aaditya-dharamshi/devboard_v1/README.md

# devboard_v1
STM32 devboard, originally developed for FIA SeeGoals
