aaditya-dharamshi/devboard_v1/Docs and Images/devboard_v1_schematic.pdf

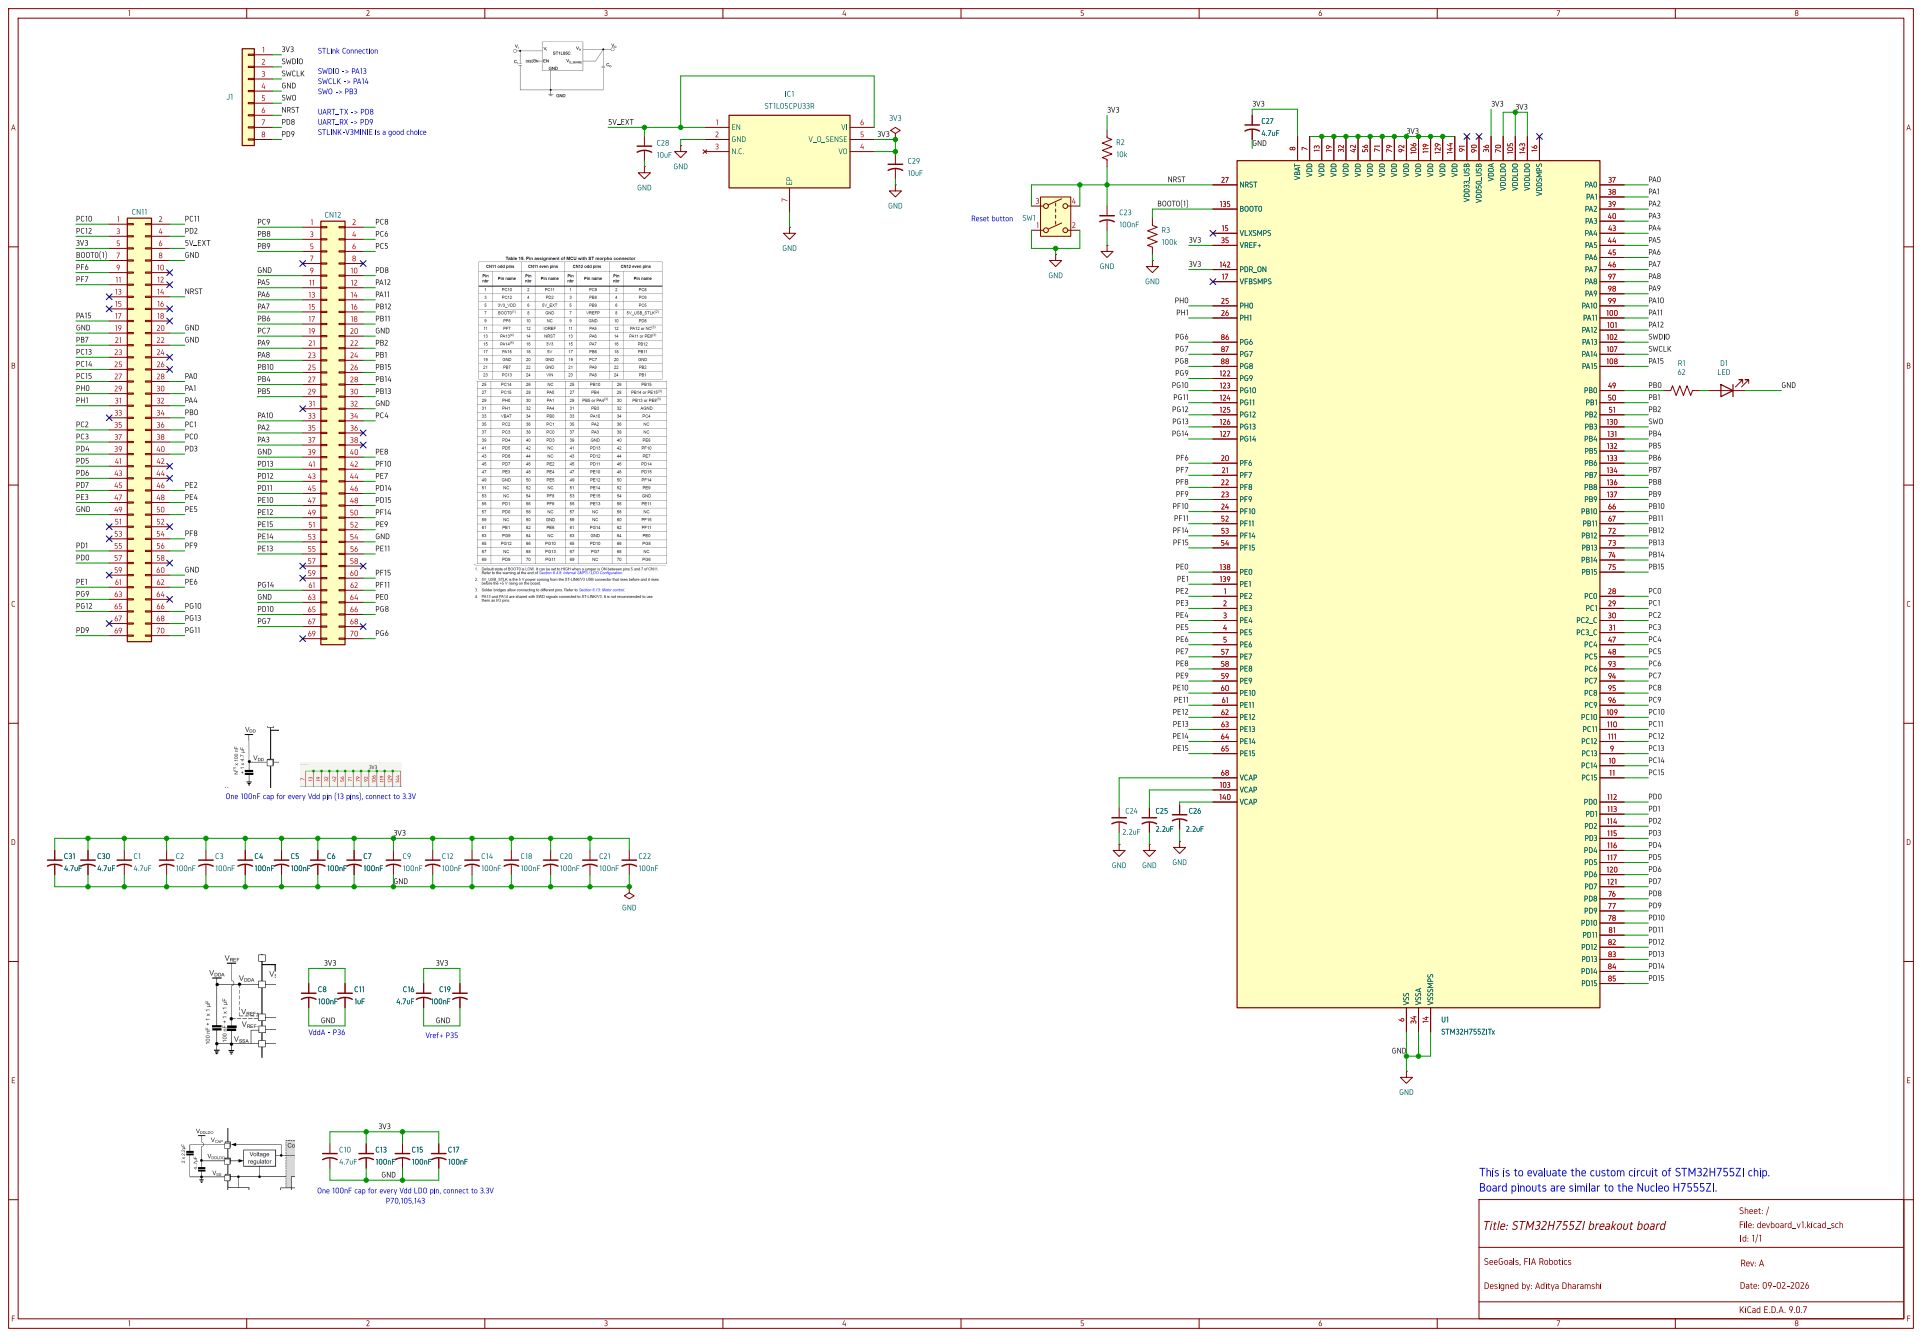
[picture p1: page 1]

6 VDD 106 VSSA 34 VDD 119 VSSSMPS 14 VDD 129 VDD 144 VDD33_USB91 VDD50_USB90 VDDA 36 VDDLDO 70 VDDLDO 105 VDDLDO 143 VDDSMPS 16 PA0 37 PA1 38 PA2 39 PA3 40 PA4 43 PA5 44 PA6 45 PA7 46 PA8 97 PA9 98 PA10 99 PA11 100 PA12 101 PA13 102 PA14 107 PA15 108 PB0 49 PB1 50 PB2 51 PB3 130 PB4 131 PB5 132 PB6 133 PB7 134 PB8 136 PB9 137 PB10 66 PB11 67 PB12 72 PB13 73 PB14 74 PB15 75 PC0 28 PC1 29 PC2_C 30 PC3_C 31 PC4 47 PC5 48 PC6 93 PC7 94 PC8 95 PC9 96 PC10 109 PC11 110 PC12 111 PC13 9 PC14 10 PC15 11 PD0 112 PD1 113 PD2 114 PD3 115 PD4 116 PD5 117 PD6 120 PD7 121 PD8 76 PD9 77 PD10 78 PD11 81 PD12 82 PD13 83 PD14 84 PD15 85 C5

6 VDD 106 VSSA 34 VDD 119 VSSSMPS 14 VDD 129 VDD 144 VDD33_USB91 VDD50_USB90 VDDA 36 VDDLDO 70 VDDLDO 105 VDDLDO 143 VDDSMPS 16 PA0 37 PA1 38 PA2 39 PA3 40 PA4 43 PA5 44 PA6 45 PA7 46 PA8 97 PA9 98 PA10 99 PA11 100 PA12 101 PA13 102 PA14 107 PA15 108 PB0 49 PB1 50 PB2 51 PB3 130 PB4 131 PB5 132 PB6 133 PB7 134 PB8 136 PB9 137 PB10 66 PB11 67 PB12 72 PB13 73 PB14 74 PB15 75 PC0 28 PC1 29 PC2_C 30 PC3_C 31 PC4 47 PC5 48 PC6 93 PC7 94 PC8 95 PC9 96 PC10 109 PC11 110 PC12 111 PC13 9 PC14 10 PC15 11 PD0 112 PD1 113 PD2 114 PD3 115 PD4 116 PD5 117 PD6 120 PD7 121 PD8 76 PD9 77 PD10 78 PD11 81 PD12 82 PD13 83 PD14 84 PD15 85 U1STM32H755ZITx

7 VDD 13 VDD 19 VDD 32 VDD 42 VDD 56 VDD 71 VDD 79 VDD 92 VSS
