aaditya-dharamshi/devboard_v1/devboard_v1.kicad_pcb

## KiCad design devboard_v1.kicad_pcb (2026-03-02)

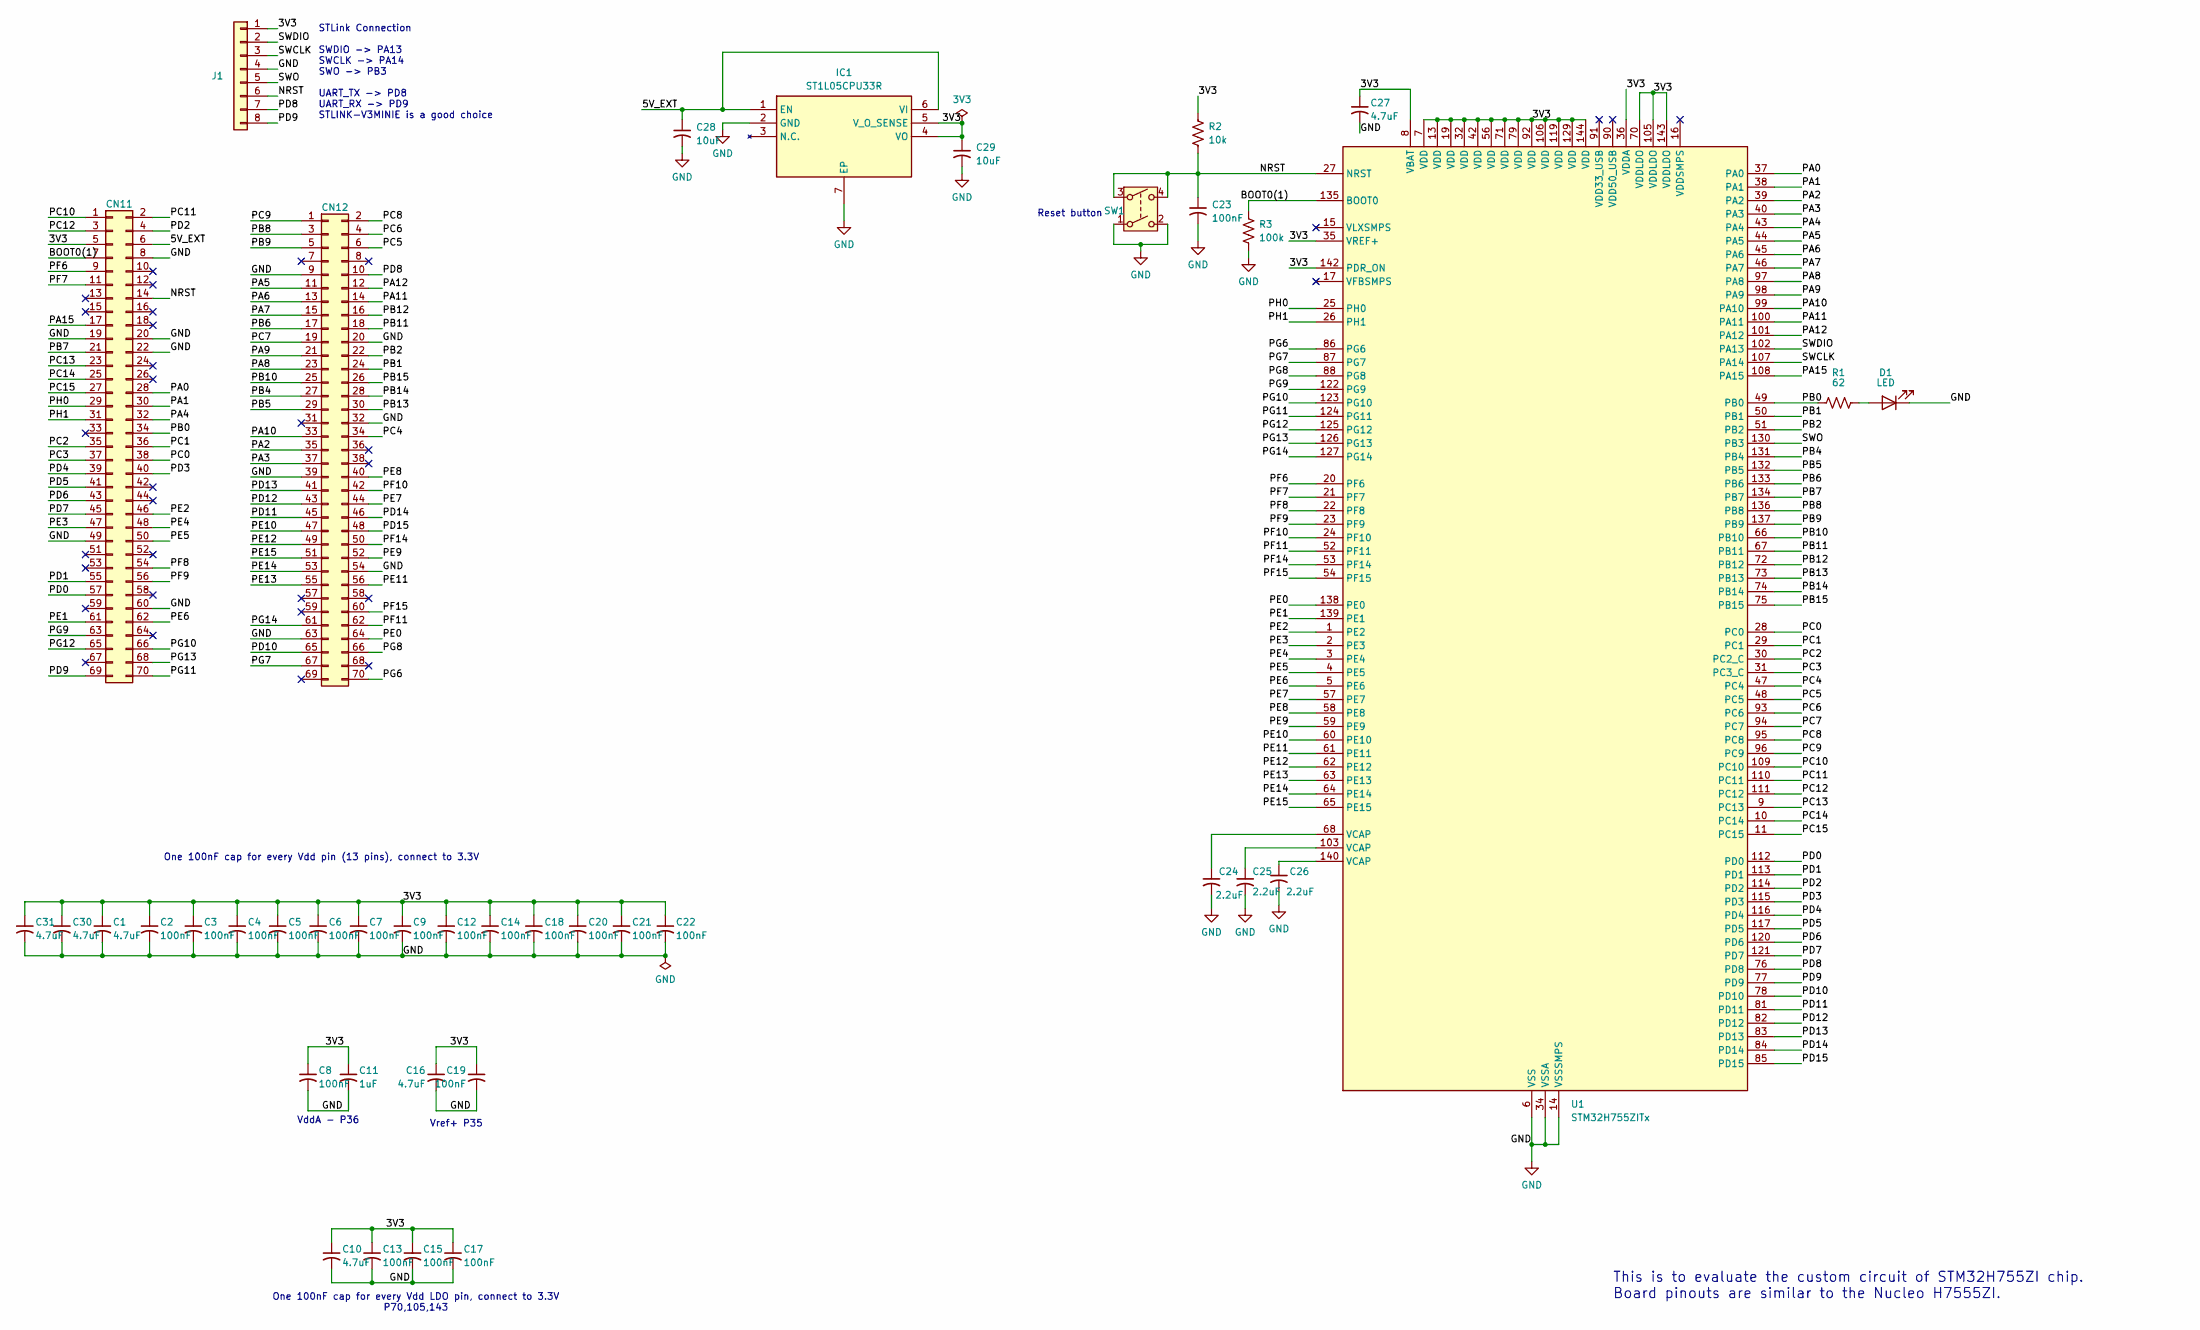
[picture p6: schematic devboard_v1.kicad_sch, STM32H755ZI breakout board]

Parts:
C1, C10, C16, C27, C30, C31: 4.7uF; C_0402_1005Metric; JLCPCB C23733
C2, C3, C4, C5, C6, C7, C8, C9, C12, C13, C14, C15, C17, C18, C19, C20, C21, C22, C23: 100nF; C_0402_1005Metric; JLCPCB C1525
C11: 1uF; C_0402_1005Metric; JLCPCB C14445
C24, C25, C26: 2.2uF; C_0402_1005Metric; JLCPCB C107369
C28, C29: 10uF; C_0402_1005Metric; JLCPCB C315248
CN11, CN12: Conn_02x36_Counter_Clockwise; PinHeader_2x35_P2.54mm_Vertical
D1: LED; LED_0603_1608Metric; JLCPCB C2286
IC1: ST1L05CPU33R; SON95P300X300X100-7N-D; Manufacturer_Part_Number ST1L05CPU33R; Mouser Part Number 511-ST1L05CPU33R
J1: Conn_01x08; PinSocket_1x08_P2.54mm_Vertical
R1: 62; R_0402_1005Metric; JLCPCB C412968
R2: 10k; R_0402_1005Metric; JLCPCB C71617
R3: 100k; R_0402_1005Metric; JLCPCB C191569
SW1: CK_KMS2xxG; TPS645-5NC105_JLCPCB; JLCPCB C19191549
U1: STM32H755ZITx; LQFP-144_20x20mm_P0.5mm; JLCPCB C730212

Connections:
/3V3: C1.1, C2.1, C3.1, C4.1, C5.1, C6.1, C7.1, C8.1, C9.1, C10.1, C11.1, C12.1, C13.1, C14.1, C15.1, C16.1, C17.1, C18.1, C19.1, C20.1, C21.1, C22.1, C27.1, C29.1, C30.1, C31.1, CN11.5, IC1.4 (VO), IC1.5 (V_O_SENSE), J1.1, R2.1, U1.7 (VDD), U1.8 (VBAT), U1.13 (VDD), U1.19 (VDD), U1.32 (VDD), U1.35 (VREF+), U1.36 (VDDA), U1.42 (VDD), U1.56 (VDD), U1.70 (VDDLDO), U1.71 (VDD), U1.79 (VDD), U1.92 (VDD), U1.105 (VDDLDO), U1.106 (VDD), U1.119 (VDD), U1.129 (VDD), U1.142 (PDR_ON), U1.143 (VDDLDO), U1.144 (VDD)
/5V_EXT: C28.1, CN11.6, IC1.1 (EN), IC1.6 (VI)
/BOOT0(1): CN11.7, R3.1, U1.135 (BOOT0)
/NRST: C23.1, CN11.14, J1.6, R2.2, SW1.3, SW1.4, U1.27 (NRST)
/PA0: CN11.28, U1.37 (PA0)
/PA1: CN11.30, U1.38 (PA1)
/PA2: CN12.35, U1.39 (PA2)
/PA3: CN12.37, U1.40 (PA3)
/PA4: CN11.32, U1.43 (PA4)
/PA5: CN12.11, U1.44 (PA5)
/PA6: CN12.13, U1.45 (PA6)
/PA7: CN12.15, U1.46 (PA7)
/PA8: CN12.23, U1.97 (PA8)
/PA9: CN12.21, U1.98 (PA9)
/PA10: CN12.33, U1.99 (PA10)
/PA11: CN12.14, U1.100 (PA11)
/PA12: CN12.12, U1.101 (PA12)
/PA15: CN11.17, U1.108 (PA15)
/PB0: CN11.34, R1.1, U1.49 (PB0)
/PB1: CN12.24, U1.50 (PB1)
/PB2: CN12.22, U1.51 (PB2)
/PB4: CN12.27, U1.131 (PB4)
/PB5: CN12.29, U1.132 (PB5)
/PB6: CN12.17, U1.133 (PB6)
/PB7: CN11.21, U1.134 (PB7)
/PB8: CN12.3, U1.136 (PB8)
/PB9: CN12.5, U1.137 (PB9)
/PB10: CN12.25, U1.66 (PB10)
/PB11: CN12.18, U1.67 (PB11)
/PB12: CN12.16, U1.72 (PB12)
/PB13: CN12.30, U1.73 (PB13)
/PB14: CN12.28, U1.74 (PB14)
/PB15: CN12.26, U1.75 (PB15)
/PC0: CN11.38, U1.28 (PC0)
/PC1: CN11.36, U1.29 (PC1)
/PC2: CN11.35, U1.30 (PC2_C)
/PC3: CN11.37, U1.31 (PC3_C)
/PC4: CN12.34, U1.47 (PC4)
/PC5: CN12.6, U1.48 (PC5)
/PC6: CN12.4, U1.93 (PC6)
/PC7: CN12.19, U1.94 (PC7)
/PC8: CN12.2, U1.95 (PC8)
/PC9: CN12.1, U1.96 (PC9)
/PC10: CN11.1, U1.109 (PC10)
/PC11: CN11.2, U1.110 (PC11)
/PC12: CN11.3, U1.111 (PC12)
/PC13: CN11.23, U1.9 (PC13)
/PC14: CN11.25, U1.10 (PC14)
/PC15: CN11.27, U1.11 (PC15)
/PD0: CN11.57, U1.112 (PD0)
/PD1: CN11.55, U1.113 (PD1)
/PD2: CN11.4, U1.114 (PD2)
/PD3: CN11.40, U1.115 (PD3)
/PD4: CN11.39, U1.116 (PD4)
/PD5: CN11.41, U1.117 (PD5)
/PD6: CN11.43, U1.120 (PD6)
/PD7: CN11.45, U1.121 (PD7)
/PD8: CN12.10, J1.7, U1.76 (PD8)
/PD9: CN11.69, J1.8, U1.77 (PD9)
/PD10: CN12.65, U1.78 (PD10)
/PD11: CN12.45, U1.81 (PD11)
/PD12: CN12.43, U1.82 (PD12)
/PD13: CN12.41, U1.83 (PD13)
/PD14: CN12.46, U1.84 (PD14)
/PD15: CN12.48, U1.85 (PD15)
/PE0: CN12.64, U1.138 (PE0)
/PE1: CN11.61, U1.139 (PE1)
/PE2: CN11.46, U1.1 (PE2)
/PE3: CN11.47, U1.2 (PE3)
/PE4: CN11.48, U1.3 (PE4)
/PE5: CN11.50, U1.4 (PE5)
/PE6: CN11.62, U1.5 (PE6)
/PE7: CN12.44, U1.57 (PE7)
/PE8: CN12.40, U1.58 (PE8)
/PE9: CN12.52, U1.59 (PE9)
/PE10: CN12.47, U1.60 (PE10)
/PE11: CN12.56, U1.61 (PE11)
/PE12: CN12.49, U1.62 (PE12)
/PE13: CN12.55, U1.63 (PE13)
/PE14: CN12.53, U1.64 (PE14)
/PE15: CN12.51, U1.65 (PE15)
/PF6: CN11.9, U1.20 (PF6)
/PF7: CN11.11, U1.21 (PF7)
/PF8: CN11.54, U1.22 (PF8)
/PF9: CN11.56, U1.23 (PF9)
/PF10: CN12.42, U1.24 (PF10)
/PF11: CN12.62, U1.52 (PF11)
/PF14: CN12.50, U1.53 (PF14)
/PF15: CN12.60, U1.54 (PF15)
/PG6: CN12.70, U1.86 (PG6)
/PG7: CN12.67, U1.87 (PG7)
/PG8: CN12.66, U1.88 (PG8)
/PG9: CN11.63, U1.122 (PG9)
/PG10: CN11.66, U1.123 (PG10)
/PG11: CN11.70, U1.124 (PG11)
/PG12: CN11.65, U1.125 (PG12)
/PG13: CN11.68, U1.126 (PG13)
/PG14: CN12.61, U1.127 (PG14)
/PH0: CN11.29, U1.25 (PH0)
/PH1: CN11.31, U1.26 (PH1)
/SWCLK: J1.3, U1.107 (PA14)
/SWDIO: J1.2, U1.102 (PA13)
/SWO: J1.5, U1.130 (PB3)
GND: C1.2, C2.2, C3.2, C4.2, C5.2, C6.2, C7.2, C8.2, C9.2, C10.2, C11.2, C12.2, C13.2, C14.2, C15.2, C16.2, C17.2, C18.2, C19.2, C20.2, C21.2, C22.2, C23.2, C24.2, C25.2, C26.2, C27.2, C28.2, C29.2, C30.2, C31.2, CN11.8, CN11.19, CN11.20, CN11.22, CN11.49, CN11.60, CN12.9, CN12.20, CN12.32, CN12.39, CN12.54, CN12.63, D1.1 (K), IC1.2 (GND), IC1.7 (EP), J1.4, R3.2, SW1.1, SW1.2, U1.6 (VSS), U1.12 (VSS), U1.14 (VSSSMPS), U1.18 (VSS), U1.33 (VSS), U1.34 (VSSA), U1.41 (VSS), U1.55 (VSS), U1.69 (VSS), U1.80 (VSS), U1.89 (VSS), U1.104 (VSS), U1.118 (VSS), U1.128 (VSS), U1.141 (VSS)
unnamed: C24.1, U1.68 (VCAP)
unnamed: C25.1, U1.103 (VCAP)
unnamed: C26.1, U1.140 (VCAP)
unnamed: D1.2 (A), R1.2

Notes on the sheet:
VddA - P36
STLink Connection SWDIO -> PA13 SWCLK -> PA14 SWO -> PB3 UART_TX -> PD8 UART_RX -> PD9 STLINK-V3MINIE is a good choice
Vref+ P35
Reset button
One 100nF cap for every Vdd LDO pin, connect to 3.3V P70,105,143
This is to evaluate the custom circuit of STM32H755ZI chip. Board pinouts are similar to the Nucleo H7555ZI.
One 100nF cap for every Vdd pin (13 pins), connect to 3.3V

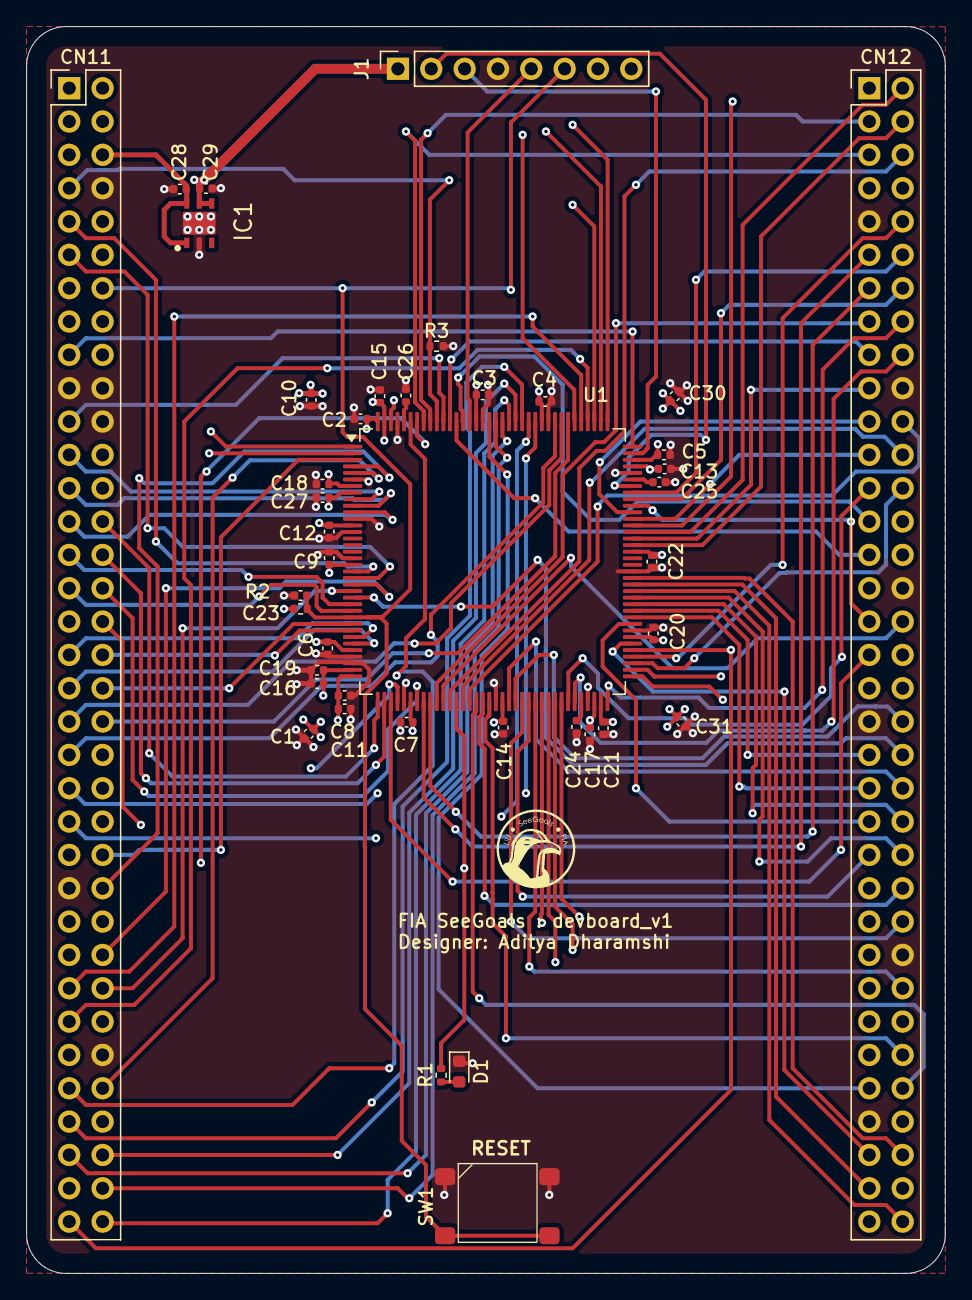
[picture p7: board devboard_v1.kicad_pcb from above]

Board: 4 copper layers, 70.0 x 95.0 mm, 41 parts (0 on the bottom side), 108 nets.
